BillAtBearGrove/MyWildThing/Small Shield - 20231209.jpg

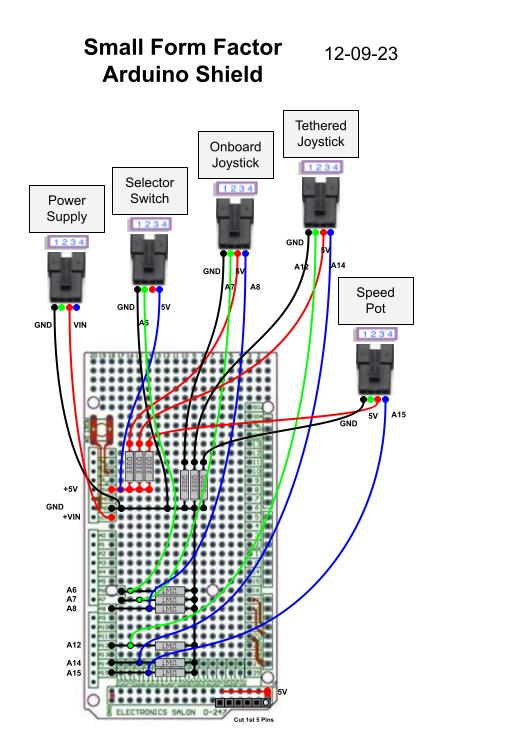
Small Shield - 20231209.jpg
