BillAtBearGrove/MyWildThing/README.md

# Arise_WildThing
Controls for Wild Thing Conversion

2024-03-02
In Progress: conversion of code to be speed control, and implementing new learn routine
