BillAtBearGrove/MyWildThing/Requirements.xlsm

Sheet: UserRequirements
Requirements Traceability Matrix |  |  |  |  | Priority | Category | Status
Project |  | Project Manager |  |  | Shall | Ease of Use | TBD
Arise Wild Thing |  | Connor McGough |  |  | Should | Performance | Coverage -InProcess
Contact |  | Date |  |  | May | Price | Coverage -Coded
 |  | 2024-02-23 |  |  | Title | Safety | Fully Tested
 |  |  |  |  | Info
USR
Req# | Priority | Requirement | Reason | Category | Status | Comments | Func# | Test Cases | L1 | L2 | L3 | L4 | L5 | L6 | isGroup | Level
USR:1 | Title | Be Safe | We like people | Safety |  |  |  |  | 1 |  |  |  |  |  | TRUE | 1
USR:1.1 | Shall | Have no unintended motion | Do not hit anybody or anything, or move into dangerous areas | Safety | Coverage -Coded |  |  |  | 1 | 1 |  |  |  |  | TRUE | 2
USR:1.1.1 | Shall | Stop if Motion Input is out of range or looks bad for considerable time | Failsafe if signal goes bad | Safety | Coverage -Coded |  |  |  | 1 | 1 | 1 |  |  |  | FALSE | 3
USR:1.1.2 | Shall | Not react to noisey signals or extreme inputs |  | Safety | Coverage -Coded | could be filtered for small noise or held previous for big variance? |  |  | 1 | 1 | 2 |  |  |  | FALSE | 3
USR:1.1.3 | Shall | Avoid any immediate motion / directional changes | Avoid surprises | Safety | Coverage -Coded |  |  |  | 1 | 1 | 3 |  |  |  | FALSE | 3
USR:2 | Shall | Switch between inputs easily and safely |  |  |  |  |  |  | 2 |  |  |  |  |  | TRUE | 1
USR:2.1 | Shall | Start in the "OFF" position when switching to new motion input |  | Safety | Coverage -Coded |  |  |  | 2 | 1 |  |  |  |  | FALSE | 2
USR:2.2 | Shall | Control rate of change of motor speeds | Keep occupant from getting dumped out of chair or jerked around; reduce surprises to operator to make easier to control | Comfort | Coverage -Coded | * Too much limitation can cause delay, hunting, or added confusion |  |  | 2 | 2 |  |  |  |  | FALSE | 2
USR:3 | Shall | Allow user adjustment of "Fast/Slow"modes |  | Ease of Use |  | Speed Pot |  |  | 3 |  |  |  |  |  | TRUE | 1
USR:3.1 | Shall | Not too Slow |  |  |  |  |  | shall still move with max child weight, on rug, up a hill? (Slowest setting) | 3 | 1 |  |  |  |  | FALSE | 2
USR:3.2 | Shall | Not Too Fast |  |  |  |  |  | shall move <TBD speed with min child weight, on smooth, down a hill? (Highest setting) | 3 | 2 |  |  |  |  | FALSE | 2
USR:3.3 | Shall | Read input from input. All the CCW is slow, CW is fast |  |  |  |  |  |  | 3 | 3 |  |  |  |  | FALSE | 2
USR:4 | Title | Don't blow up |  |  |  |  |  |  | 4 |  |  |  |  |  | TRUE | 1
USR:4.1 | Shall | Battery storage must be safe over -20F to 110F |  |  |  |  |  |  | 4 | 1 |  |  |  |  | FALSE | 2

Sheet: ECMRequirements
Requirements Traceability Matrix |  |  |  |  | Priority | Category | Status
Project |  | Project Manager |  |  | Shall | Ease of Use | TBD
Arise Wild Thing |  | Connor McGough |  |  | Should | Performance | Coverage -InProcess
Contact |  | Date |  |  | May | Price | Coverage -Coded
 |  | 2024-02-23 |  |  | Title | Safety | Fully Tested
 |  |  |  |  | Info
ECM
Req# | Priority | Requirement | Reason | Category | Status | Comments | Func# | Test Cases | L1 | L2 | L3 | L4 | L5 | L6 | isGroup | Level
ECM:1 | Title | Price |  | Price |  |  |  |  | 1 |  |  |  |  |  | TRUE | 1
ECM:1.1 | Shall | Be accessible to all levels of income |  |  |  |  |  |  | 1 | 1 |  |  |  |  | FALSE | 2
ECM:2 | Title | Availability |  | Safety | Coverage -Coded |  |  |  | 2 |  |  |  |  |  | TRUE | 1
ECM:2.1 | Shall | Purchase from standard sources |  |  |  |  |  |  | 2 | 1 |  |  |  |  | FALSE | 2
ECM:3 | Title | Flexibility |  |  |  |  |  |  | 3 |  |  |  |  |  | TRUE | 1
ECM:3.1 | Should | be able to modify/customize to suit individual needs |  |  |  |  |  |  | 3 | 1 |  |  |  |  | FALSE | 2
ECM:4 | Title | Distribution |  |  |  |  |  |  | 4 |  |  |  |  |  | TRUE | 1
ECM:4.1 | Shall | have all critical tuning parameters easy to use |  |  |  |  |  |  | 4 | 1 |  |  |  |  | FALSE | 2
ECM:4.2 | Shall | Be robust to mis-use / entry error of all critical tuning parameters |  |  |  |  |  |  | 4 | 2 |  |  |  |  | FALSE | 2
