BillAtBearGrove/MyWildThing/MEGA VNH5019 HARNESS WIRING v4_0.pdf

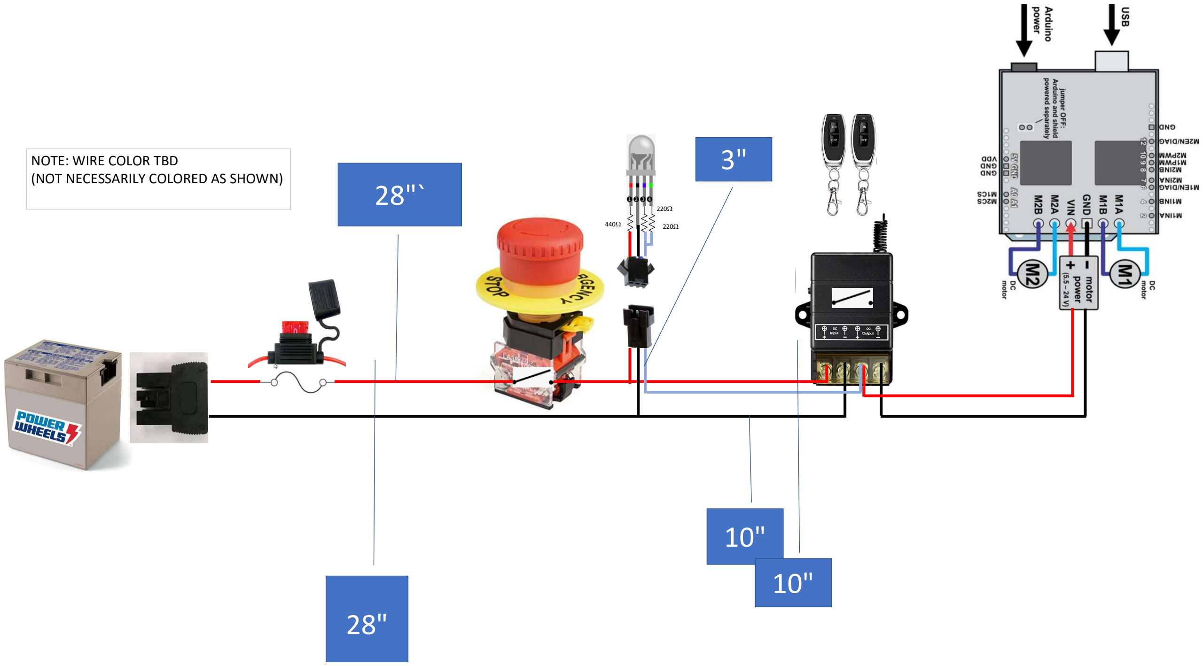
[picture p2: figure]
NOTE: WIRE COLOR TBD; (NOT NECESSARILY COLORED AS SHOWN)
