BillAtBearGrove/MyWildThing/SpeedCalcTesting.xlsx

Sheet: No Load Rampup
Lv | LmA | SpeedTarget | SpeedCalc
-34.16 | 199.66 | -34.16 | -36.11652192
-30.92 | 188.69 | -30.92 | -32.65997328
-27.87 | 131.66 | -27.87 | -29.58770592
-25.17 | 63.13 | -25.17 | -26.93815056
-24.91 | 49.24 | -24.91 | -26.71135488
-24.91 | 78.87 | -24.91 | -26.59615344
-24.3 | 91.26 | -24.3 | -25.88918112
-23.08 | 91.85 | -23.08 | -24.5692872
-20.19 | 61.16 | -20.19 | -21.56740992
-18.94 | 43.99 | -18.94 | -20.28416688
-18.65 | 41.54 | -18.65 | -19.98049248
-18.25 | 49.84 | -18.25 | -19.51622208
-17.51 | 54.81 | -17.51 | -18.69769872
-16.19 | 27.04 | -16.19 | -17.38006848
-14.67 | 1.84 | -14.67 | -15.83644608
-13.62 | 15.89 | -13.62 | -14.64781968
-12.65 | 4.95 | -12.65 | -13.6427544
-6.34 | 1.37 | -6.34 | -6.84187344
-5.43 | 0.01 | -5.43 | -5.86436112
-4.53 | 0 | -4.53 | -4.8924
-3.58 | 0 | -3.58 | -3.8664
-2.7 | 0 | -2.7 | -2.916
-1.8 | 0 | -1.8 | -1.944
-0.87 | 0 | -0.87 | -0.9396
0 | 0 | 0 | 0
0 | 0 | 0 | 0
0 | 0 | 0 | 0
0 | 0 | 0 | 0
0 | 0 | 0 | 0
0 | 0 | 0 | 0
0 | 0 | 0 | 0
0 | 0 | 0 | 0
0 | 0 | 0 | 0
0 | 0 | 0 | 0
0 | 0 | 0 | 0
0 | 0 | 0 | 0
0 | 0 | 0 | 0
0 | 0 | 0 | 0
0 | 0 | 0 | 0
0 | 0 | 0 | 0
0 | 0 | 0 | 0
0 | 0 | 0 | 0
0 | 0 | 0 | 0
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
