BillAtBearGrove/MyWildThing/MEGA VNH5019 SHIELD WIRING v4_1 (WobbleSwitch).pdf

## NOTE: Traces and Resistors can be mounted on TOP or

BOTTOM of shield (between shield & Arduino MEGA).

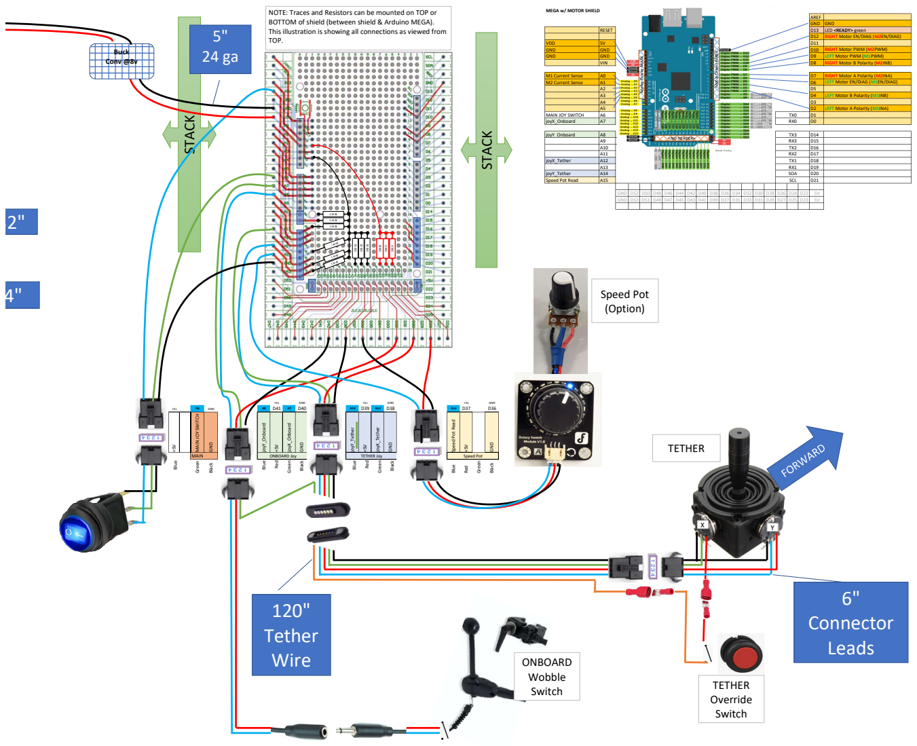
[picture p3: page 1]

AREF
GND | GND

This illustration is showing all connections as viewed from

GND | D52 | D50 | D48 | D46 | D44 | D42 | D40 | D38 | D36 | D34 | D32 | D30 | D28 | D26 | D24 | D22 | 5V
GND | D53 | D51 | D49 | D47 | D45 | D43 | D41 | D39 | D37 | D35 | D33 | D31 | D29 | D27 | D25 | D23 | 5V
