BillAtBearGrove/MyWildThing/WobbleSwitchWiring_Overall.pdf

1k | STACKNOTE: WIRE COLOR TBD
(NOT NECESSARILY COLORED AS SHOWN) | 6"

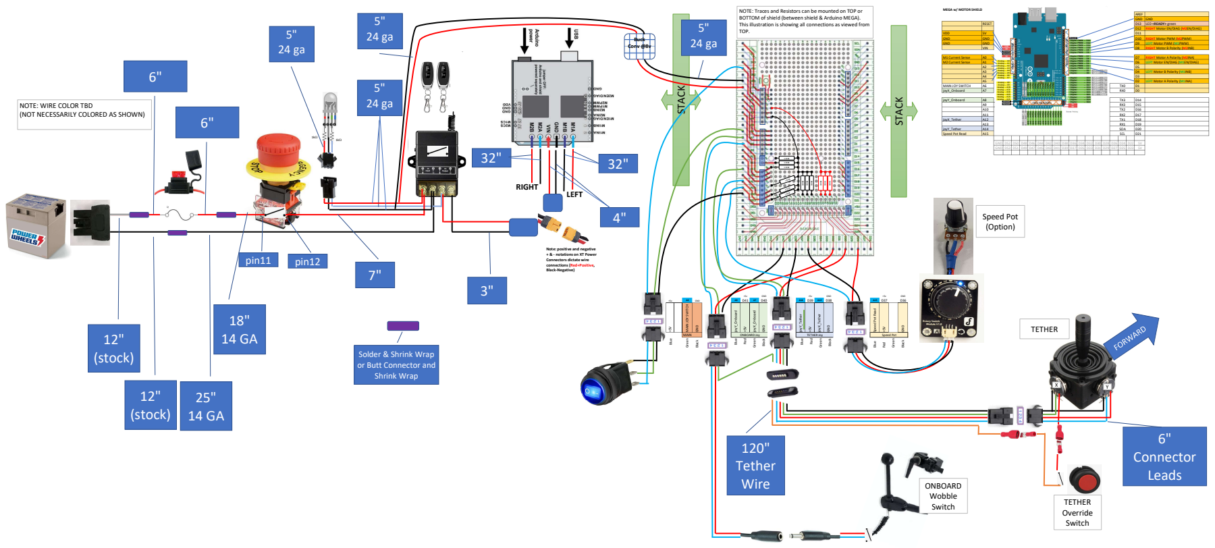
[picture p4: page 1]

AREF
GND | GND

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

4" Note: positive and negative + & - notations on XT Power Connectors dictate wire connections (Red+Positive, Black-Negative)

Solder & Shrink Wrap
or Butt Connector and
Shrink Wrap
