BillAtBearGrove/MyWildThing/MEGA VNH5019 SHIELD WIRING v4_0.pdf

NOTE: Traces and Resistors can be mounted on TOP or BOTTOM of shield (between shield & Arduino MEGA). This illustration is showing all connections as viewed from TOP. | 330 Ω

## 1 M Ω

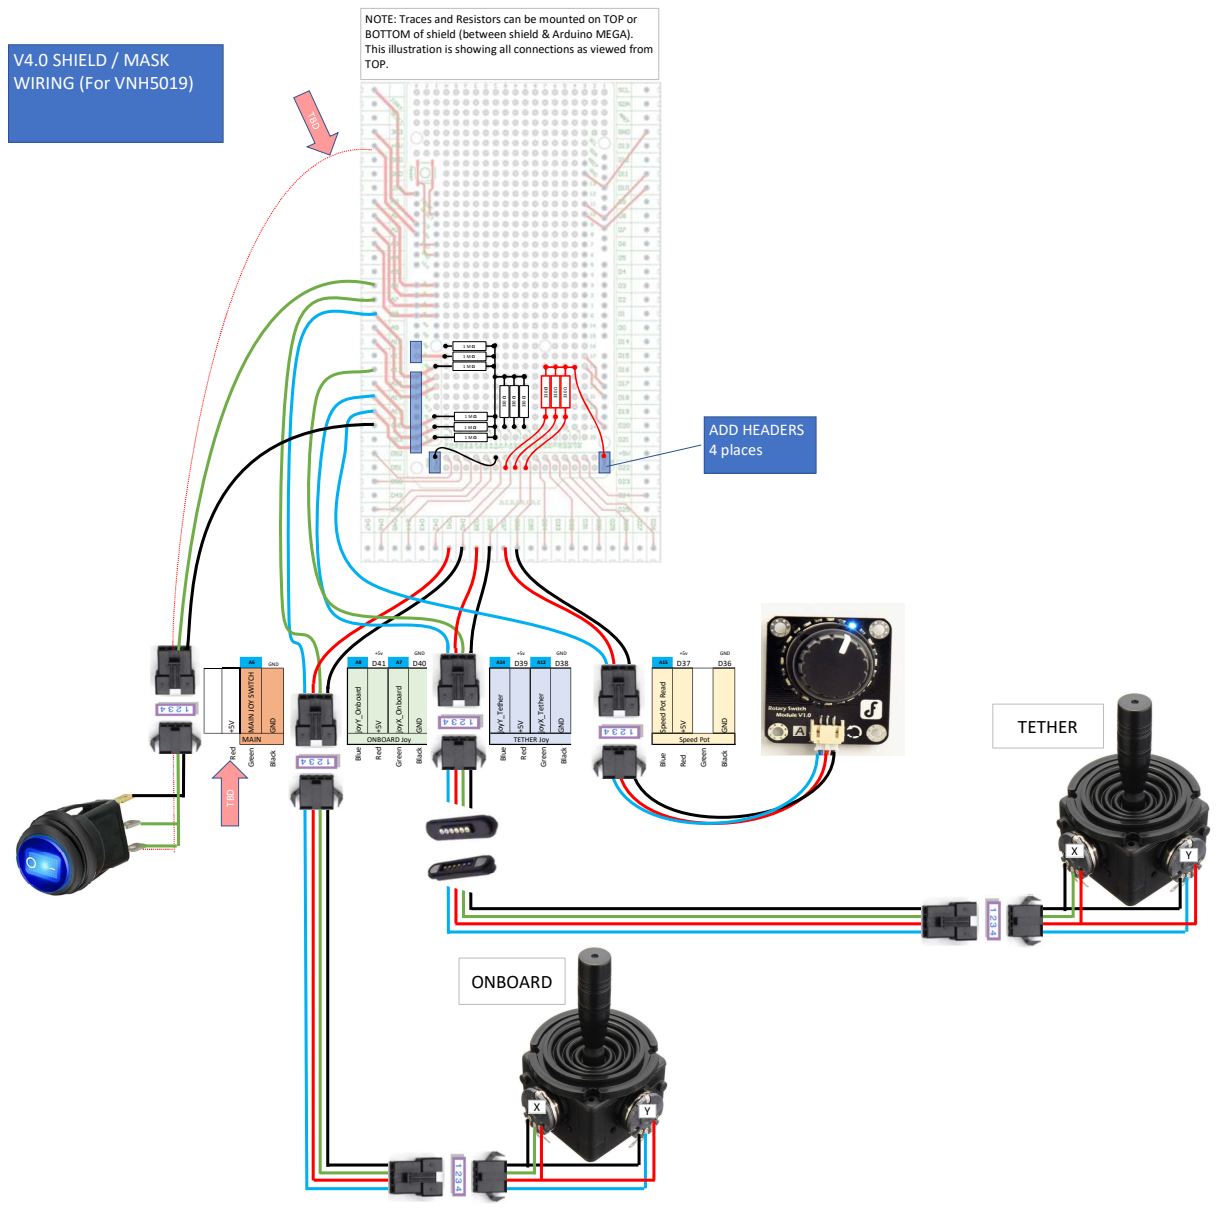
[picture p5: page 1]
GND; MAIN JOY SWITCH; joyY_Onboard; joyX_Onboard; joyY_Tether; joyX_Tether; Speed Pot Read; MAIN Red; Green; Black; Blue; Red; ONBOARD Joy; TETHER Joy; Speed Pot; X Y ONBOARD; TETHER TBD; V4.0 SHIELD / MASK WIRING (For VNH5019)

ADD HEADERS 4 places
