BillAtBearGrove/MyWildThing/LookupTable_RadiusToSpeed.pdf

# Converting Joystick A2D to Desired Spin & Velocity

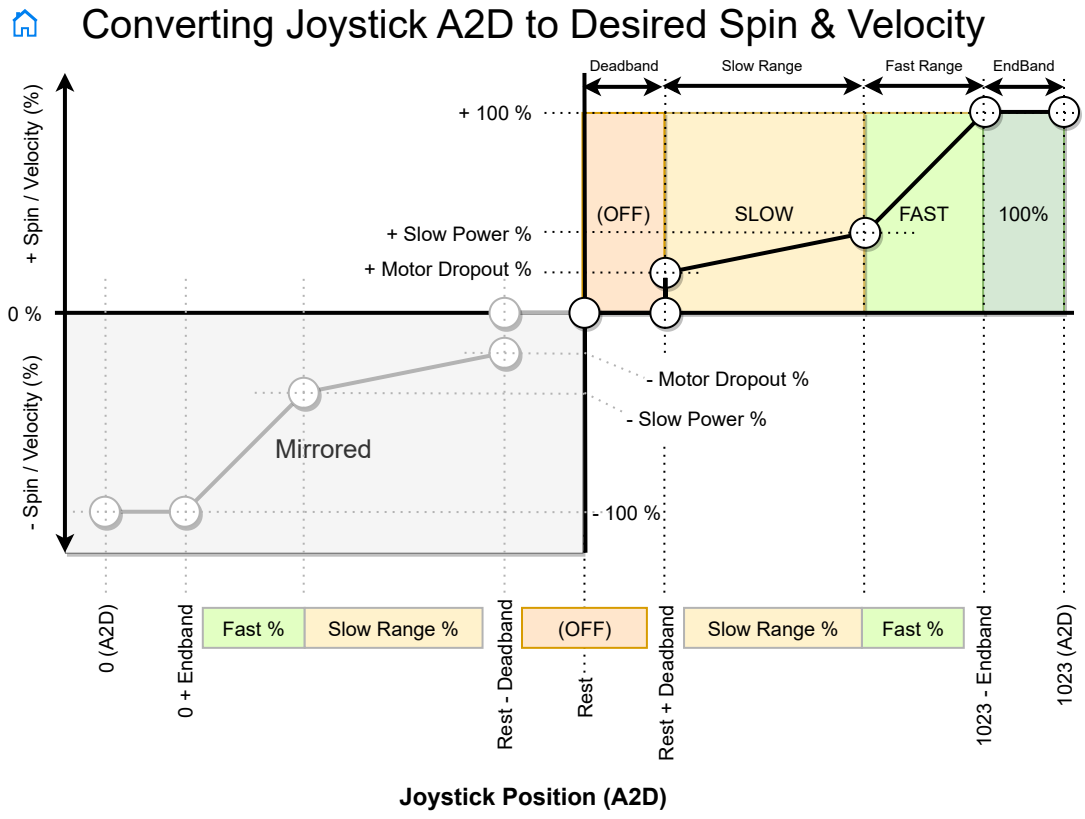
[picture p6: page 1]
Joystick Position (A2D); (OFF); SLOW; FAST; Mirrored; Deadband; Slow Range; Fast Range; EndBand; + Motor Dropout %; + Slow Power %; - Motor Dropout %; - Slow Power %; Rest; Rest + Deadband; Rest - Deadband; 1023 - Endband; 0 + Endband; Fast %; Slow Range %

+ Spin / Velocity (%) - Spin / Velocity (%)
