BillAtBearGrove/MyWildThing/LookupTable_AngleToMix.pdf

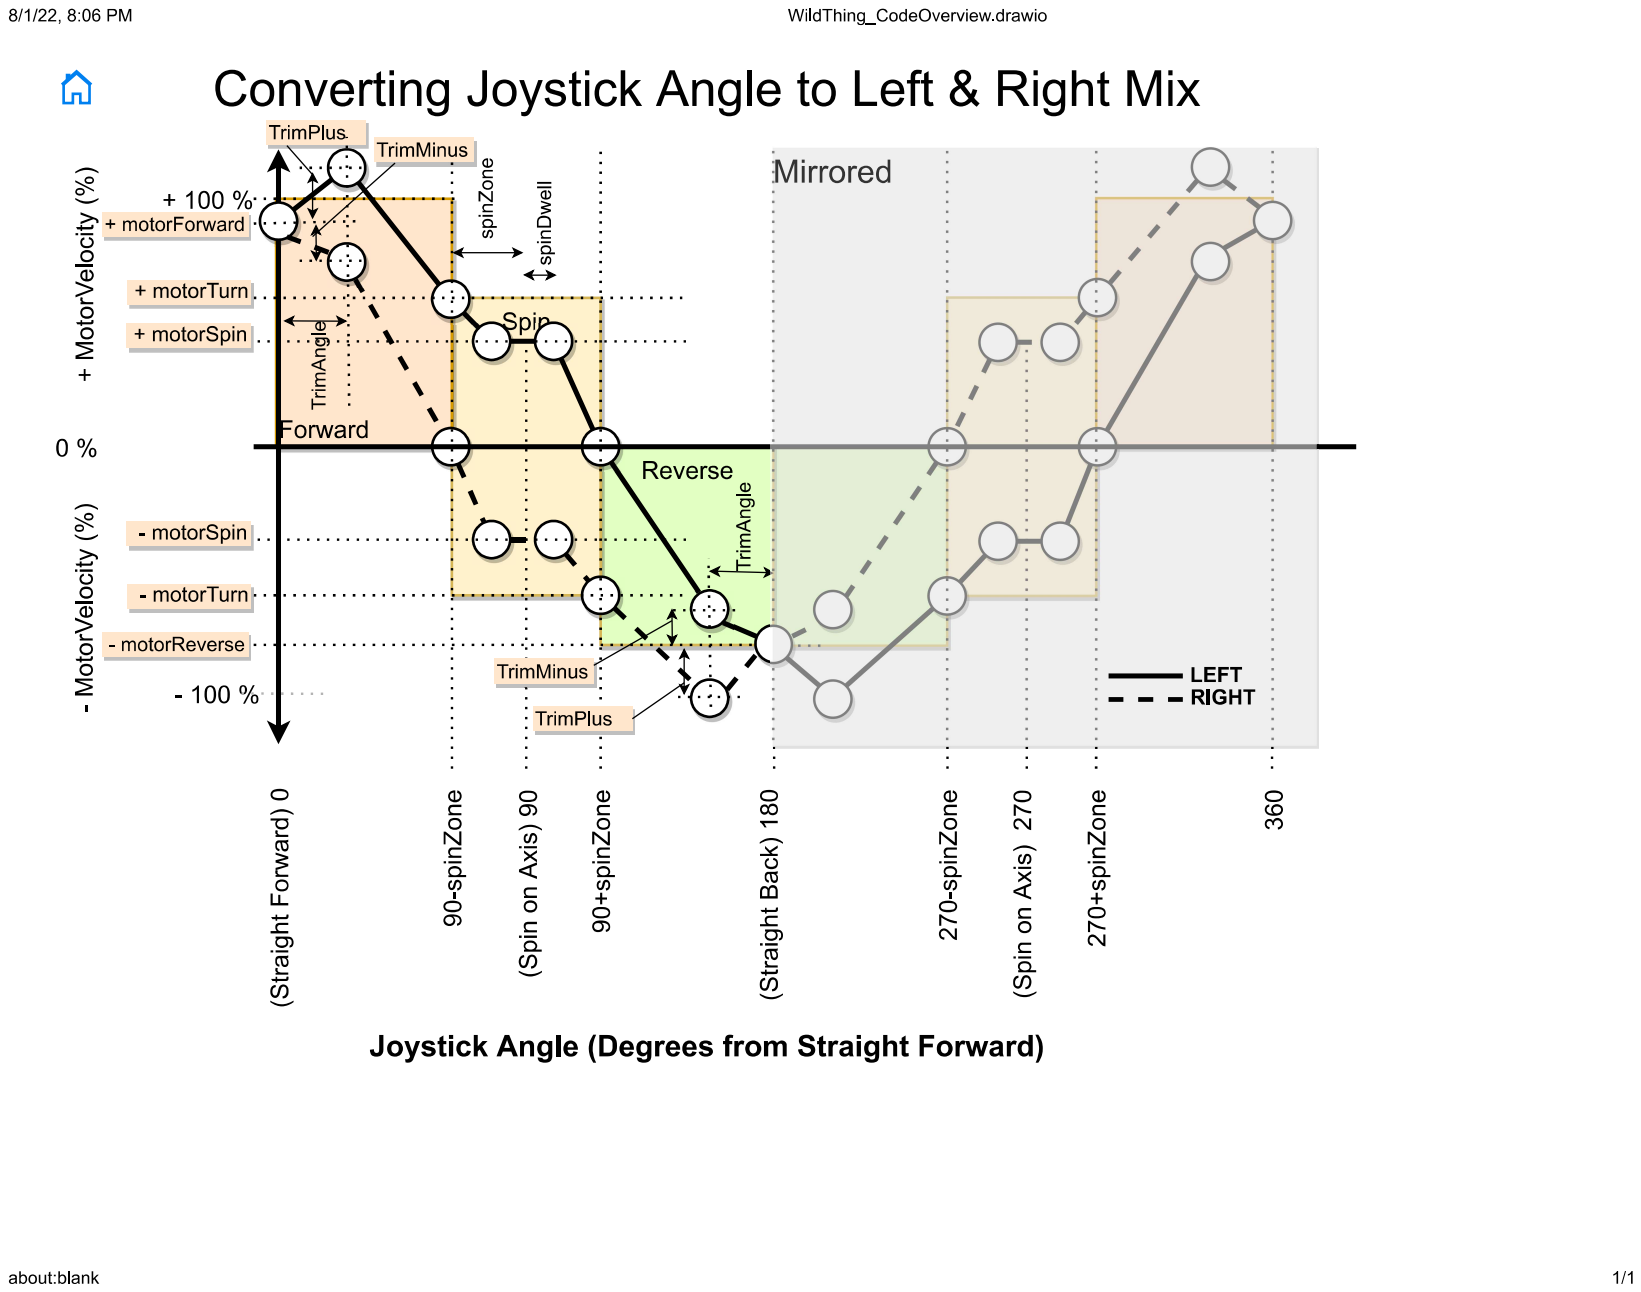
[picture p7: page 1]
