BillAtBearGrove/MyWildThing/ARISE_WildThing/src/sd_update.cpp

// From https://chat.openai.com/share/6864dead-439d-4618-9f69-a6c8a724e246

/*
****************************************************************
ARISE Adaptive Design
Project: WildThing ESP32 Port
Author: ejc
****************************************************************
Change Log:
-Changes Made. MM.DD.YYYY
--Initial codebase - 03.18.2024
****************************************************************
Notes:
-Note. MM.DD.YYYY
--Initial codebase - 03.18.2024
****************************************************************
*/

// #include <WiFi.h>
#include <SD.h>
//#include "../include/Update.h"

/* const char *ssid = "your_wifi_ssid";
const char *password = "your_wifi_password"; */

#define UPDATE_FILE "/update.bin"

void performUpdate() {
  Serial.println("Starting update...");

  // Open update file
  File updateFile = SD.open(UPDATE_FILE);
  if (!updateFile) {
    Serial.println("Failed to open update file!");
    return;
  }

  // Update ESP32 firmware
  if (Update.begin()) {
    size_t written = Update.writeStream(updateFile);
    if (written == updateFile.size()) {
      Serial.println("Update completed successfully!");
    } else {
      Serial.println("Update failed!");
    }
    if (Update.end()) {
      Serial.println("Restarting ESP32...");
      ESP.restart();
    } else {
      Serial.println("Error occurred during update!");
    }
  } else {
    Serial.println("Failed to begin update!");
  }

  updateFile.close();
}

// void setup() {
//   Serial.begin(115200);

// /*   // Connect to WiFi
//   Serial.println("Connecting to WiFi...");
//   WiFi.begin(ssid, password);
//   while (WiFi.status() != WL_CONNECTED) {
//     delay(1000);
//     Serial.println("Connecting...");
//   }
//   Serial.println("Connected to WiFi"); */

//   // Mount SD card
//   if (!SD.begin()) {
//     Serial.println("Failed to mount SD card!");
//     return;
//   }
//   Serial.println("SD card mounted...");

//   // Check if update file exists
//   if (SD.exists(UPDATE_FILE)) {
//     Serial.println("Update file found...");
//     // Perform update
//     performUpdate();
//   } else {
//     Serial.println("No update file found!");
//   }

//   // Your application code here
// }

// void loop() {
//   // Your loop code here
// }
