BillAtBearGrove/MyWildThing/ARISE_WildThing/include/build_info_constants.h

#ifndef BUILD_INFO_CONSTANTS_H
#define BUILD_INFO_CONSTANTS_H

#define BUILD_DATE "Mon, Jan 27, 2025 6:49:13 PM"
#define GIT_BRANCH "feature/WTI-30-sw-port-test"
#define MAJOR_VERSION "1"
#define MINOR_VERSION "0"
#define PATCH_VERSION "18"
#define COMMIT_HASH "e3c485e"

#endif // BUILD_INFO_CONSTANTS_H
