BillAtBearGrove/MyWildThing/(commit log)

2024-03-03 Starting to cleanup logic - still compiles but haven't checked how it works - just want a copy Copied speed control basics and working in joyProcessing.h and .ino to add autocenter
    [Requirements.xlsm]
2024-03-03 PARTIAL TESTED: joystick input management from last night - tether works with diagnostic noise/disconnect and auto learn works NEED TO: 1) redo function to simplify switching between inputs 2) check 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
    [ARISE_WildThing.ino, Debounce.cpp, Debounce.h, Init.h]
2024-03-03 tested and fixed reset when changing joystick inputs
    [ARISE_WildThing.ino]
2024-03-03 PID Working but not tuned - AND need to redo logic to switch between Drive & Braking anyway
2025-03-24 continued tuning for PID and made changes to allow keyboard input to change debug print to command window
    [OutlineExample.xlsm, Requirements.xlsm, Requirements_Sketch.xlsm, SpeedCalcTesting.xlsx]
2025-03-25 clear out everything
    [OutlineExample.xlsm, Requirements_Sketch.xlsm, SpeedCalcTesting.xlsx]
2025-03-25 Copy C:\Users\wsmit\ECM_Arise\wildthing-collaboration\ARISE_WildThing files [IO-Cleanup] and reorganize to new folder structure
    [Requirements.xlsm, SpeedCalcTesting.xlsx]
2025-04-09 <Intermediate commit. Non-Functional> Added and connected a bunch of h files to try to reduce errors. Still seeing excessive errors related to restructure of software and VNH7070 implimentation.
    [Requirements.xlsm]
2025-04-27 Create Notes_OnStatus.txt
    added a couple note to keep track of status
